donpivo/uTracer/README.md

Project description: https://retronics.no/tag/utracer/
