donpivo/uTracer/Models/TubePlate_Frame.stl

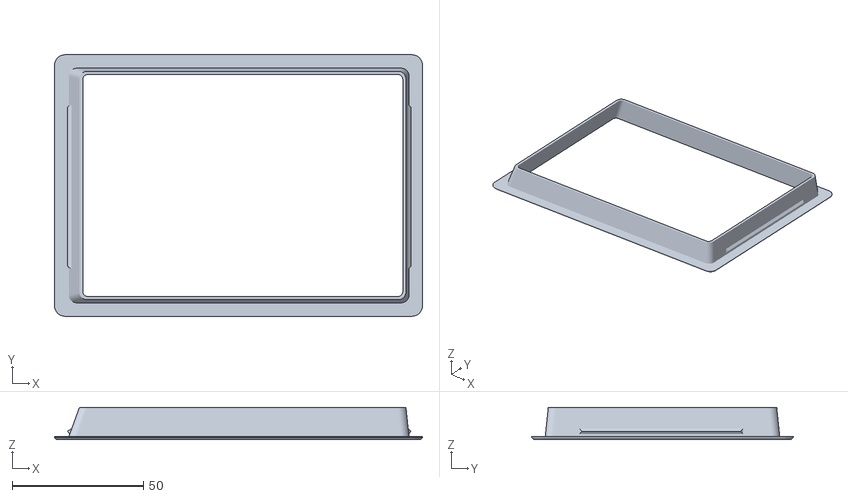
[picture p1: CAD file, 2023-02-20]
Models/TubePlate_Frame.stl
140.0 x 99.5 x 12.3
