donpivo/uTracer/Models/HeaterFrontPanel.3mf

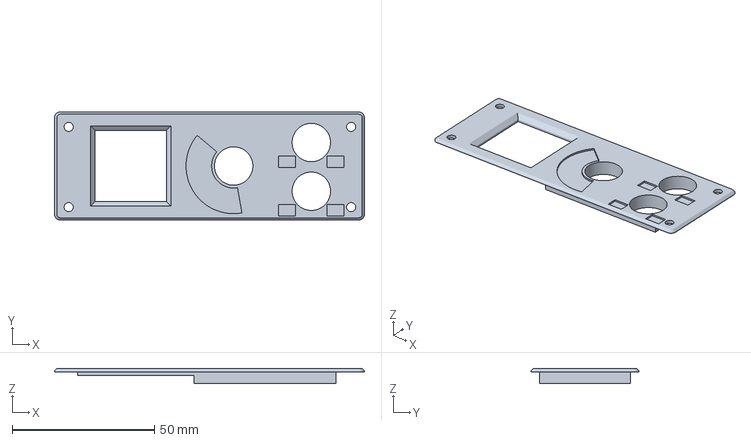
[picture p2: CAD file, 2023-02-17]
Models/HeaterFrontPanel.3mf
109.0 x 38.0 x 5.20 mm
