donpivo/uTracer/Models/ConnectorPlate.stl

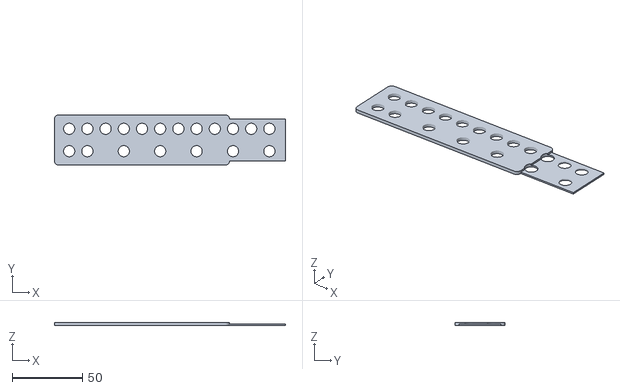
[picture p3: CAD file, 2023-02-17]
Models/ConnectorPlate.stl
165.0 x 36.0 x 2.10
