donpivo/uTracer/Models/HeaterFrontPanel_Insert.stl

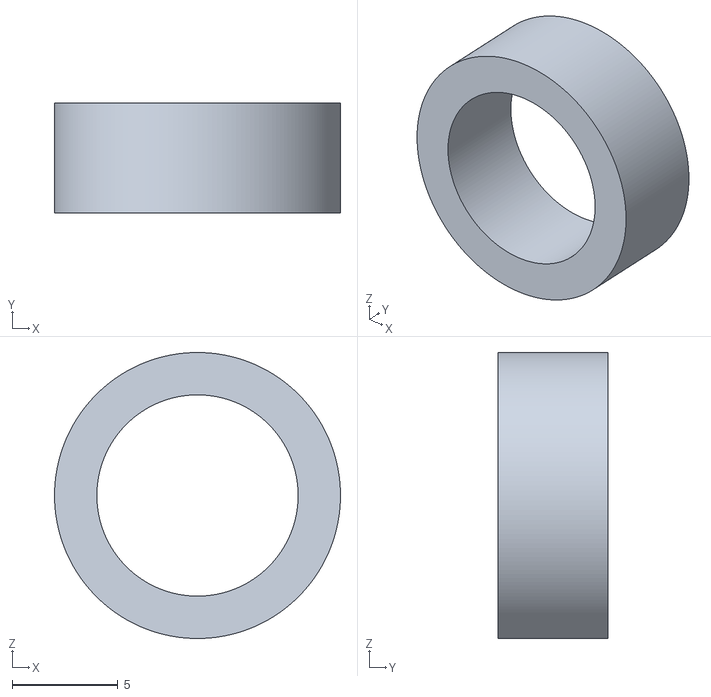
[picture p4: CAD file, 2023-02-16]
Models/HeaterFrontPanel_Insert.stl
13.5 x 5.20 x 13.5
