donpivo/uTracer/Models/CableProtection_2A.stl

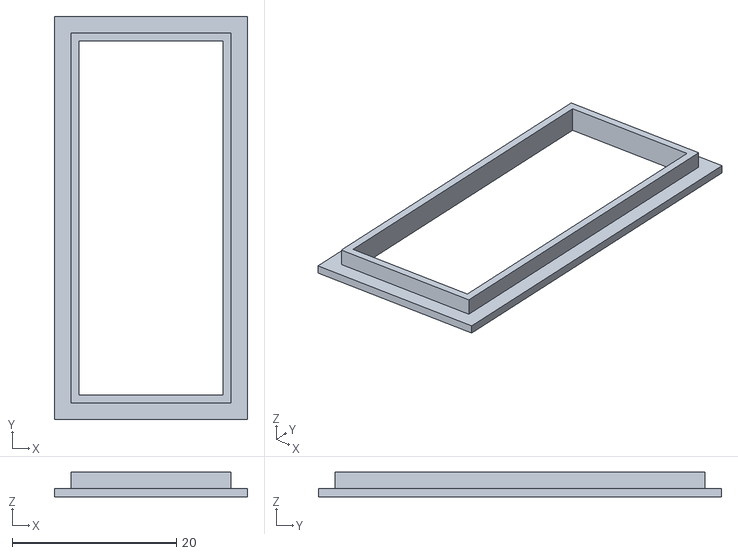
[picture p5: CAD file, 2023-01-22]
Models/CableProtection_2A.stl
23.5 x 49.0 x 3.00
