donpivo/uTracer/Models/CableProtection_1A.stl

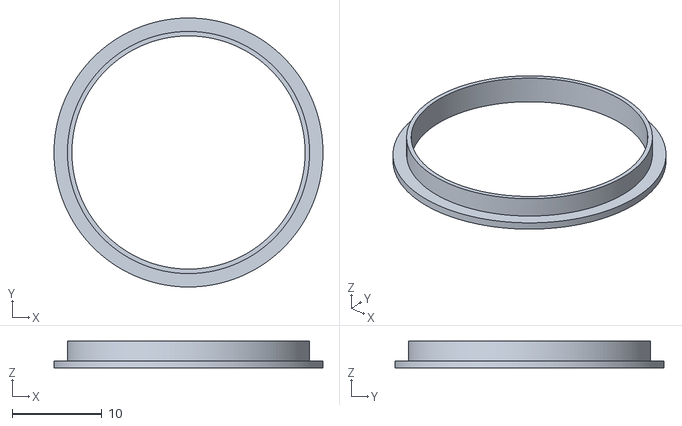
[picture p6: CAD file, 2023-01-22]
Models/CableProtection_1A.stl
30.0 x 30.0 x 3.00
