donpivo/uTracer/Models/CableProtection_1B.stl

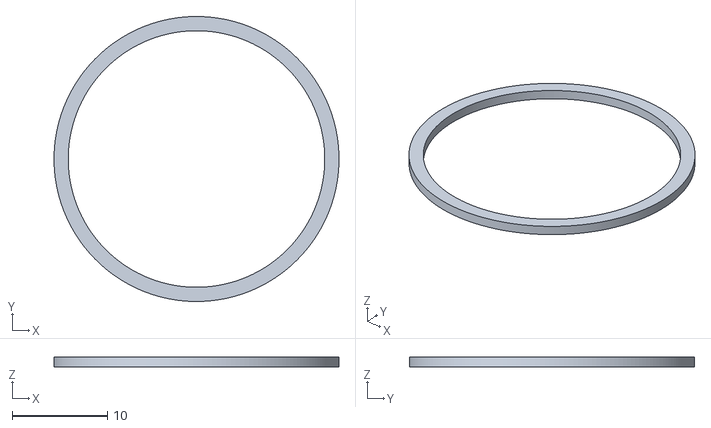
[picture p7: CAD file, 2023-01-22]
Models/CableProtection_1B.stl
30.0 x 30.0 x 1.00
