donpivo/uTracer/Models/CableProtection_2B.stl

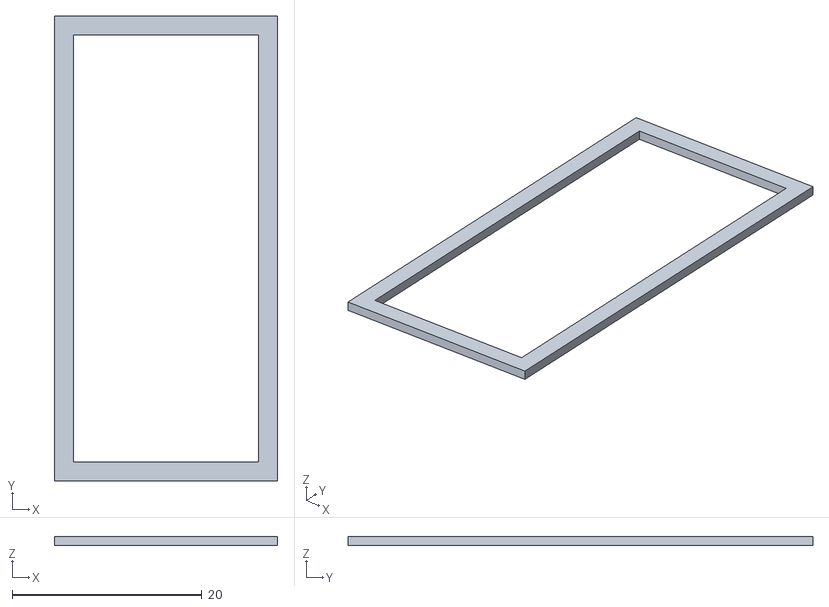
[picture p8: CAD file, 2023-01-22]
Models/CableProtection_2B.stl
23.5 x 49.0 x 1.00
