donpivo/uTracer/Models/HeaterHolder.stl

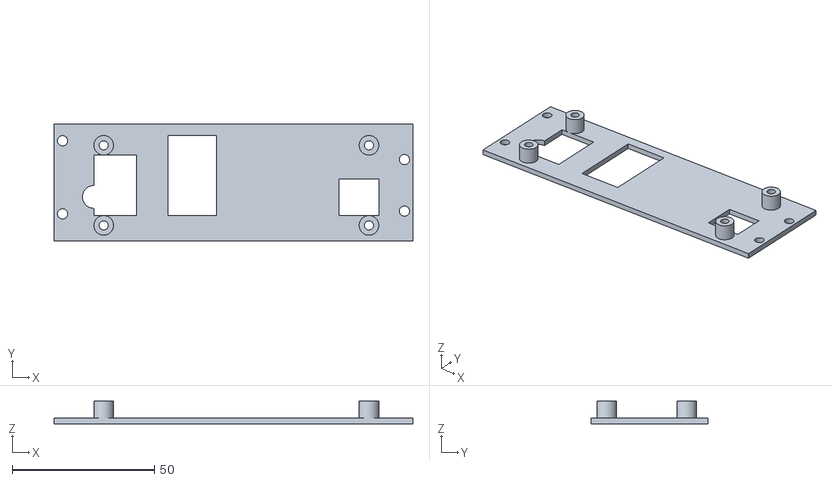
[picture p9: CAD file, 2023-01-22]
Models/HeaterHolder.stl
126.0 x 41.0 x 8.00
