donpivo/uTracer/Models/USBCover.stl

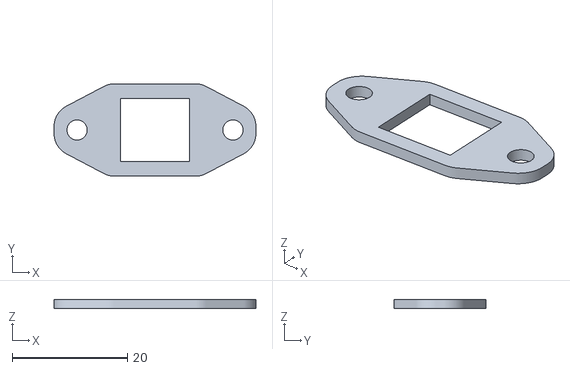
[picture p10: CAD file, 2023-01-12]
Models/USBCover.stl
35.0 x 16.0 x 1.60
