donpivo/uTracer/Models/ShieldHolder.stl

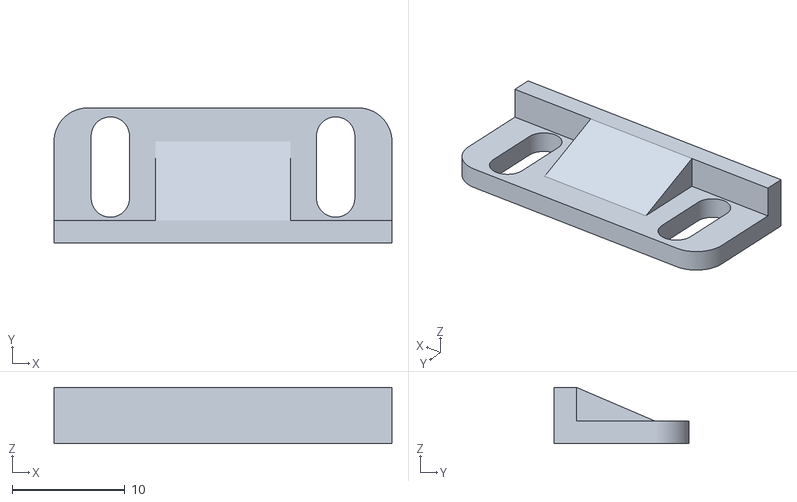
[picture p11: CAD file, 2022-11-03]
Models/ShieldHolder.stl
30.0 x 12.0 x 5.00
