donpivo/uTracer/(list of files, cad)

Other CAD files:
Models/TubePlate_Frame2.stl
Models/HeaterFrontPanel.stl
