donpivo/uTracer/Schematic/HeaterMCU/HeaterMCU.kicad_pcb

## KiCad design Schematic/HeaterMCU/HeaterMCU.kicad_pcb (2023-05-12)

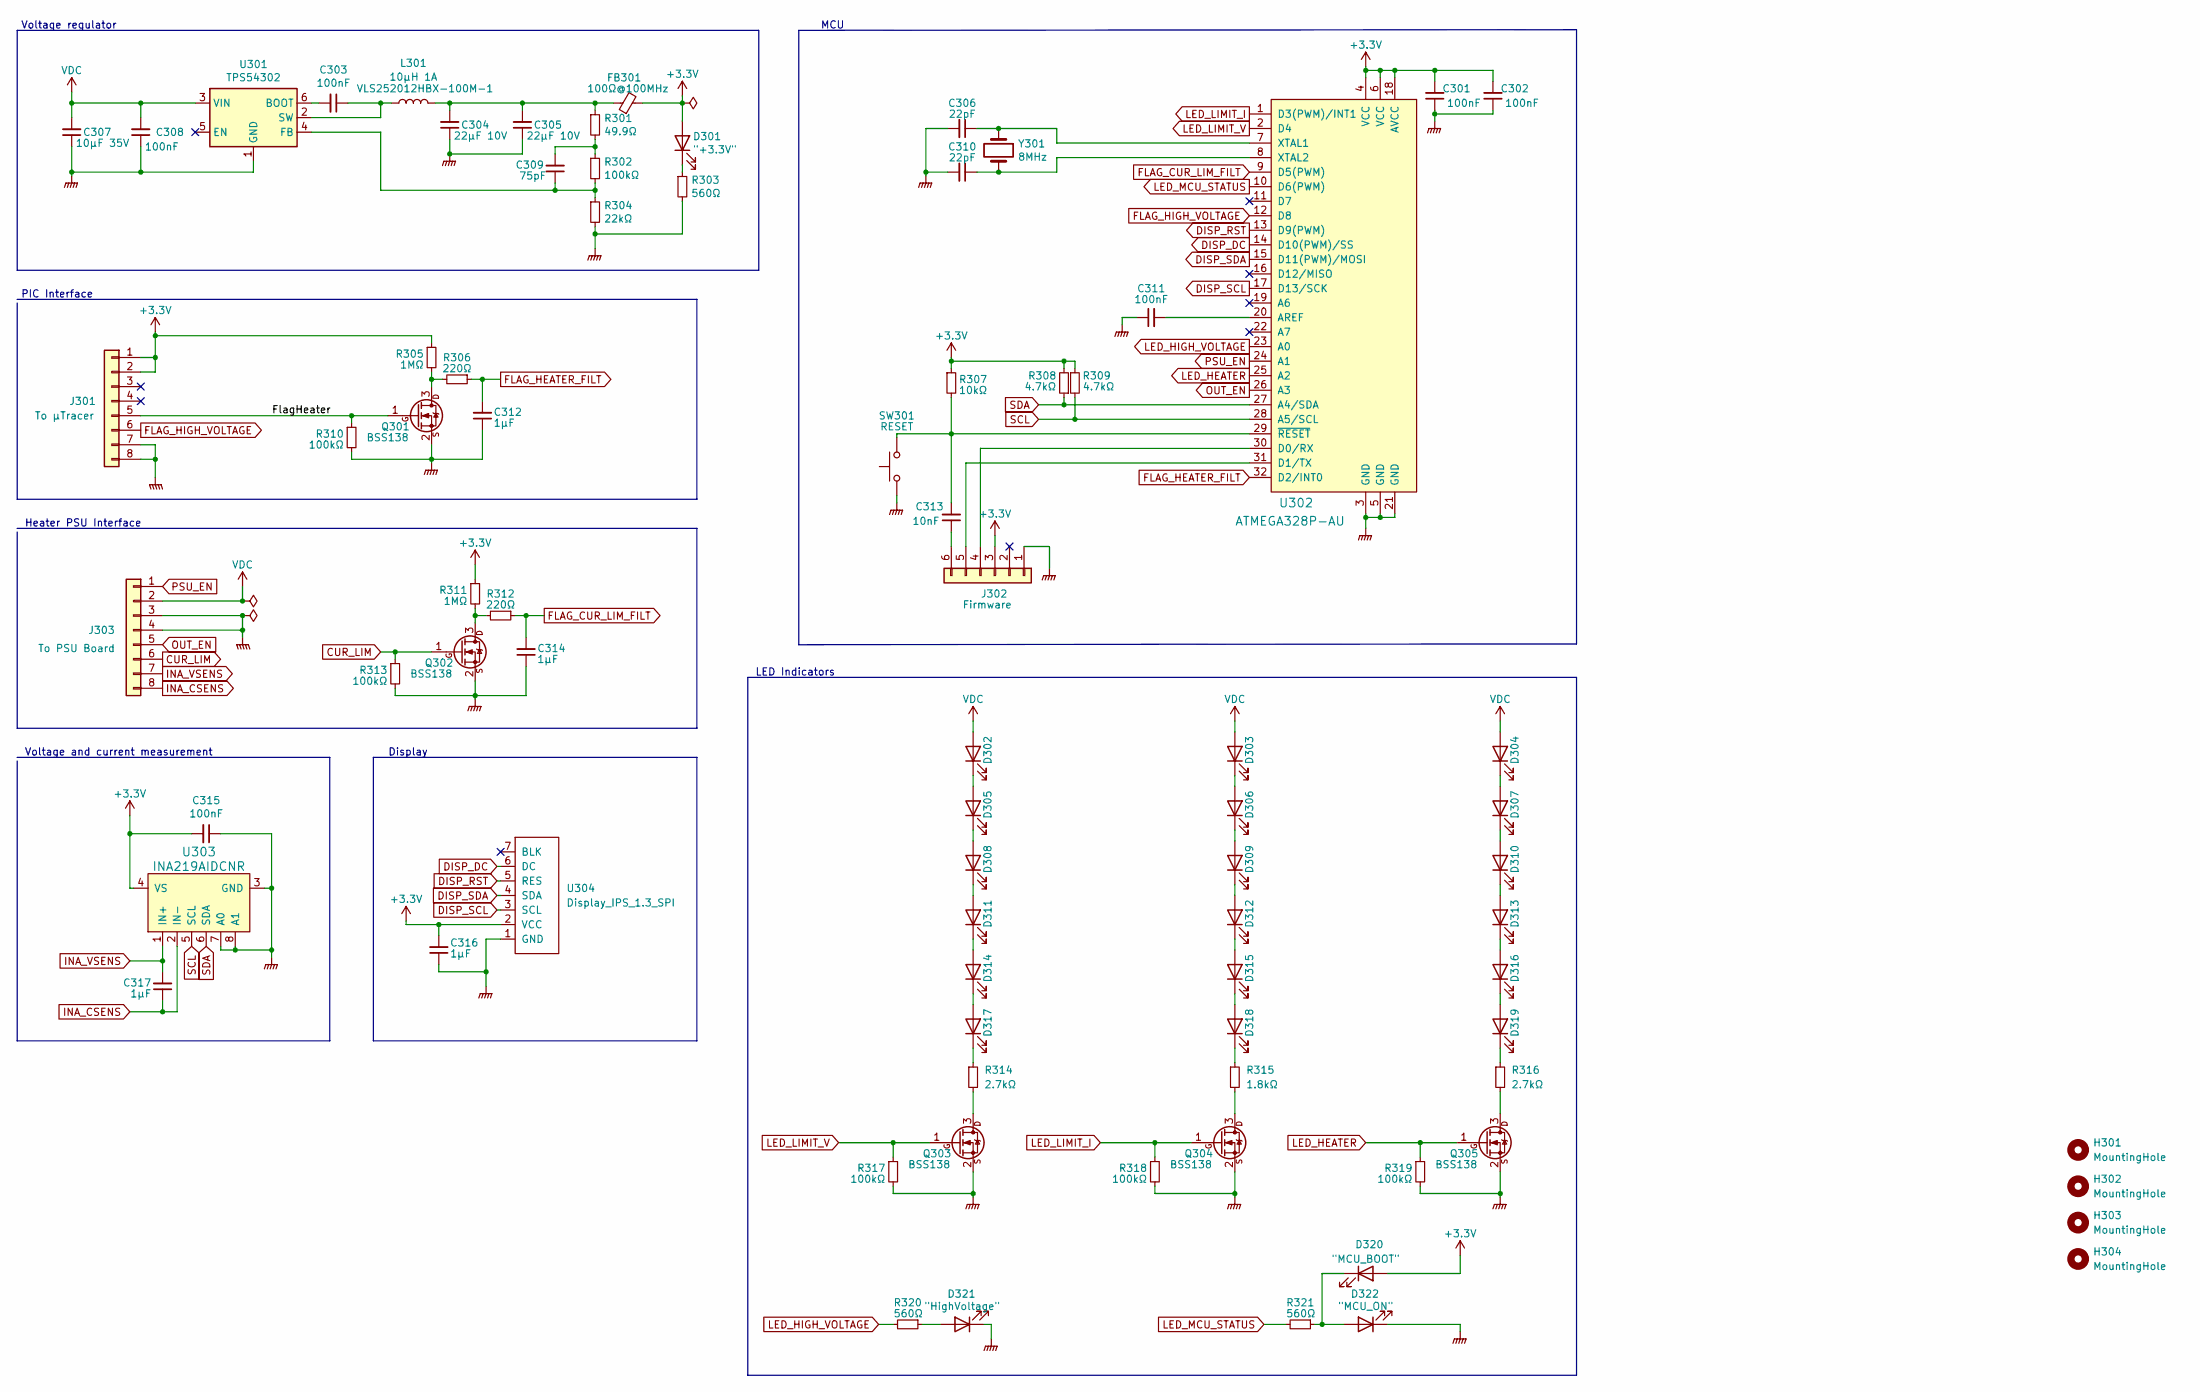
[picture p12: schematic HeaterMCU.kicad_sch, uTracer Heater - MCU Board]

Parts:
C301, C302, C303, C308, C311, C315: 100nF; C_0603_1608Metric_Pad1.08x0.95mm_HandSolder
C304, C305: 22µF 10V; C_0603_1608Metric_Pad1.08x0.95mm_HandSolder
C306, C310: 22pF; C_0603_1608Metric_Pad1.08x0.95mm_HandSolder
C307: 10µF 35V; C_0603_1608Metric_Pad1.08x0.95mm_HandSolder
C309: 75pF; C_0603_1608Metric_Pad1.08x0.95mm_HandSolder
C312, C314, C316, C317: 1µF; C_0603_1608Metric_Pad1.08x0.95mm_HandSolder
C313: 10nF; C_0603_1608Metric_Pad1.08x0.95mm_HandSolder
D301: "+3.3V"; LED_0603_1608Metric_Pad1.05x0.95mm_HandSolder
D302, D305, D308, D311, D314, D317: "Voltage limit"; LED_0603_1608Metric_Pad1.05x0.95mm_HandSolder
D303, D306, D309, D312, D315, D318: "Current limit"; LED_0603_1608Metric_Pad1.05x0.95mm_HandSolder
D304, D307, D310, D313, D316, D319: "Heater"; LED_0603_1608Metric_Pad1.05x0.95mm_HandSolder
D320: "MCU_BOOT"; LED_0603_1608Metric_Pad1.05x0.95mm_HandSolder
D321: "HighVoltage"; LED_0603_1608Metric_Pad1.05x0.95mm_HandSolder
D322: "MCU_ON"; LED_0603_1608Metric_Pad1.05x0.95mm_HandSolder
FB301: 100Ω@100MHz; L_0603_1608Metric_Pad1.05x0.95mm_HandSolder
H301, H302, H303, H304: MountingHole; MountingHole_3.2mm_M3
J301: To µTracer; 0527450897
J302: Firmware; PinHeader_1x06_P2.54mm_Vertical
J303: To PSU Board; PinHeader_1x08_P2.54mm_Vertical
L301: 10µH 1A; L_Taiyo-Yuden_NR-20xx_HandSoldering
Q301, Q302, Q303, Q304, Q305: BSS138; SOT-23
R301: 49.9Ω; R_0603_1608Metric_Pad0.98x0.95mm_HandSolder
R302, R310, R313, R317, R318, R319: 100kΩ; R_0603_1608Metric_Pad0.98x0.95mm_HandSolder
R303, R320, R321: 560Ω; R_0603_1608Metric_Pad0.98x0.95mm_HandSolder
R304: 22kΩ; R_0603_1608Metric_Pad0.98x0.95mm_HandSolder
R305, R311: 1MΩ; R_0603_1608Metric_Pad0.98x0.95mm_HandSolder
R306, R312: 220Ω; R_0603_1608Metric_Pad0.98x0.95mm_HandSolder
R307: 10kΩ; R_0603_1608Metric_Pad0.98x0.95mm_HandSolder
R308, R309: 4.7kΩ; R_0603_1608Metric_Pad0.98x0.95mm_HandSolder
R314, R316: 2.7kΩ; R_0603_1608Metric_Pad0.98x0.95mm_HandSolder
R315: 1.8kΩ; R_0603_1608Metric_Pad0.98x0.95mm_HandSolder
SW301: RESET; Tactile_sw_SMD_side_01
U301: TPS54302; SOT-23-6_Handsoldering
U302: ATMEGA328P-AU; TQFP-32_7x7mm
U303: INA219AIDCNR; SOT-23-8_Handsoldering; MPN INA219AIDCNR; Digi-Key_PN 296-23770-1-ND
U304: Display_IPS_1.3_SPI
Y301: 8MHz; Crystal_SMD_HC49-SD

Connections:
+3V3: C301.2, C302.2, C315.2, C316.2, D301.2 (A), D320.2 (A), FB301.2, J301.1, J301.2, J302.3, R305.1, R307.1, R308.2, R309.1, R311.1, U302.4 (VCC), U302.6 (VCC), U302.18 (AVCC), U303.4 (VS), U304.2 (VCC)
/FlagHeater: J301.5, Q301.1 (G), R310.1
CUR_LIM: J303.6, Q302.1 (G), R313.1
DISP_DC: U302.14 (D10(PWM)/SS), U304.6 (DC)
DISP_RST: U302.13 (D9(PWM)), U304.5 (RES)
DISP_SCL: U302.17 (D13/SCK), U304.3 (SCL)
DISP_SDA: U302.15 (D11(PWM)/MOSI), U304.4 (SDA)
FLAG_CUR_LIM_FILT: C314.2, R312.1, U302.9 (D5(PWM))
FLAG_HEATER_FILT: C312.2, R306.1, U302.32 (D2/INT0)
FLAG_HIGH_VOLTAGE: J301.6, U302.12 (D8)
GNDPWR: C301.1, C302.1, C304.1, C305.1, C306.2, C307.1, C308.1, C310.2, C311.1, C312.1, C314.1, C315.1, C316.1, D321.1 (K), D322.1 (K), J301.7, J301.8, J302.1, J303.3, J303.4, Q301.2 (S), Q302.2 (S), Q303.2 (S), Q304.2 (S), Q305.2 (S), R303.2, R304.2, R310.2, R313.2, R317.2, R318.2, R319.2, SW301.1, U301.1 (GND), U302.3 (GND), U302.5 (GND), U302.21 (GND), U303.3 (GND), U303.7 (A0), U303.8 (A1), U304.1 (GND)
INA_CSENS: C317.1, J303.8, U303.2 (IN-)
INA_VSENS: C317.2, J303.7, U303.1 (IN+)
LED_HEATER: Q305.1 (G), R319.1, U302.25 (A2)
LED_HIGH_VOLTAGE: R320.2, U302.23 (A0)
LED_LIMIT_I: Q304.1 (G), R318.1, U302.1 (D3(PWM)/INT1)
LED_LIMIT_V: Q303.1 (G), R317.1, U302.2 (D4)
LED_MCU_STATUS: R321.2, U302.10 (D6(PWM))
unnamed: C303.1, L301.1, U301.2 (SW)
unnamed: C303.2, U301.6 (BOOT)
unnamed: C304.2, C305.2, FB301.1, L301.2, R301.1
unnamed: C306.1, U302.7 (XTAL1), Y301.1
unnamed: C309.1, R302.2, R304.1, U301.4 (FB)
unnamed: C309.2, R301.2, R302.1
unnamed: C310.1, U302.8 (XTAL2), Y301.2
unnamed: C311.2, U302.20 (AREF)
unnamed: C313.1, J302.6
unnamed: C313.2, R307.2, SW301.2, U302.29 (~RESET)
unnamed: D301.1 (K), R303.1
unnamed: D302.1 (K), D305.2 (A)
unnamed: D303.1 (K), D306.2 (A)
unnamed: D304.1 (K), D307.2 (A)
unnamed: D305.1 (K), D308.2 (A)
unnamed: D306.1 (K), D309.2 (A)
unnamed: D307.1 (K), D310.2 (A)
unnamed: D308.1 (K), D311.2 (A)
unnamed: D309.1 (K), D312.2 (A)
unnamed: D310.1 (K), D313.2 (A)
unnamed: D311.1 (K), D314.2 (A)
unnamed: D312.1 (K), D315.2 (A)
unnamed: D313.1 (K), D316.2 (A)
unnamed: D314.1 (K), D317.2 (A)
unnamed: D315.1 (K), D318.2 (A)
unnamed: D316.1 (K), D319.2 (A)
unnamed: D317.1 (K), R314.1
unnamed: D318.1 (K), R315.1
unnamed: D319.1 (K), R316.1
unnamed: D320.1 (K), D322.2 (A), R321.1
unnamed: D321.2 (A), R320.1
unnamed: J302.4, U302.30 (D0/RX)
unnamed: J302.5, U302.31 (D1/TX)
unnamed: Q301.3 (D), R305.2, R306.2
unnamed: Q302.3 (D), R311.2, R312.2
unnamed: Q303.3 (D), R314.2
unnamed: Q304.3 (D), R315.2
unnamed: Q305.3 (D), R316.2
OUT_EN: J303.5, U302.26 (A3)
PSU_EN: J303.1, U302.24 (A1)
SCL: R309.2, U302.28 (A5/SCL), U303.5 (SCL)
SDA: R308.1, U302.27 (A4/SDA), U303.6 (SDA)
VDC: C307.2, C308.2, D302.2 (A), D303.2 (A), D304.2 (A), J303.2, U301.3 (VIN)

Notes on the sheet:
Voltage regulator
Heater PSU Interface
Display
PIC Interface
LED Indicators
MCU
Voltage and current measurement

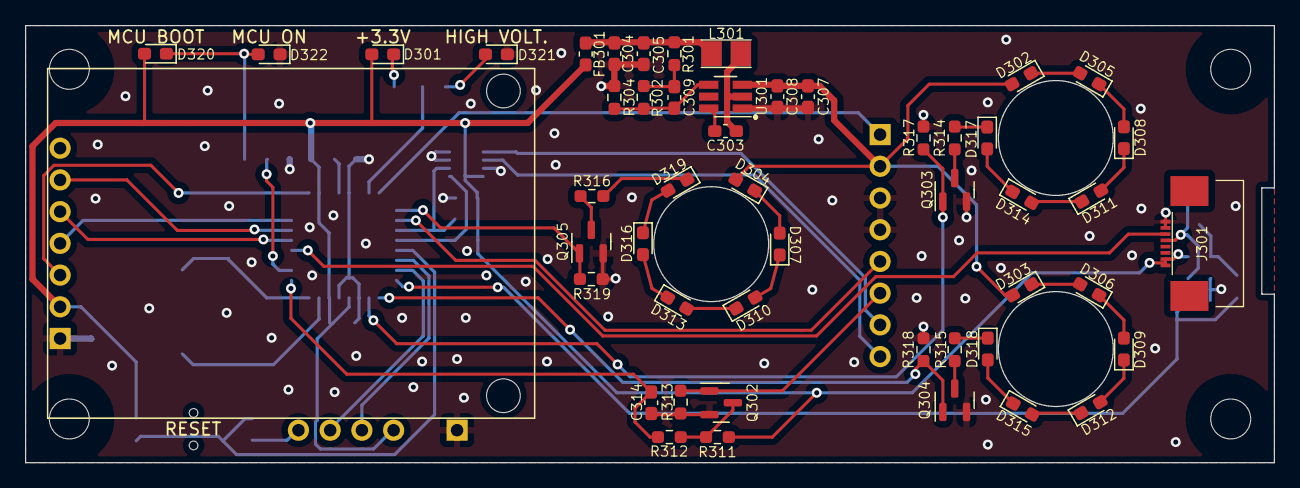
[picture p13: board HeaterMCU.kicad_pcb from above]

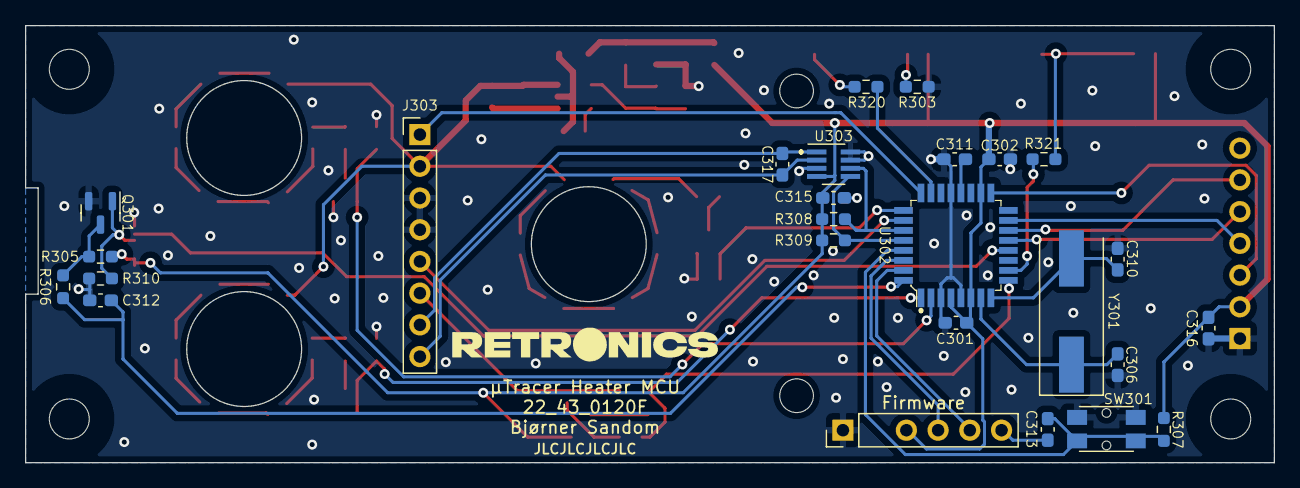
[picture p14: board HeaterMCU.kicad_pcb from below]

Board: 2 copper layers, 100.0 x 35.0 mm, 80 parts (26 on the bottom side), 61 nets.
