donpivo/uTracer/Schematic/HeaterPSU/HeaterPSU.kicad_pcb

## KiCad design Schematic/HeaterPSU/HeaterPSU.kicad_pcb (2023-01-23)

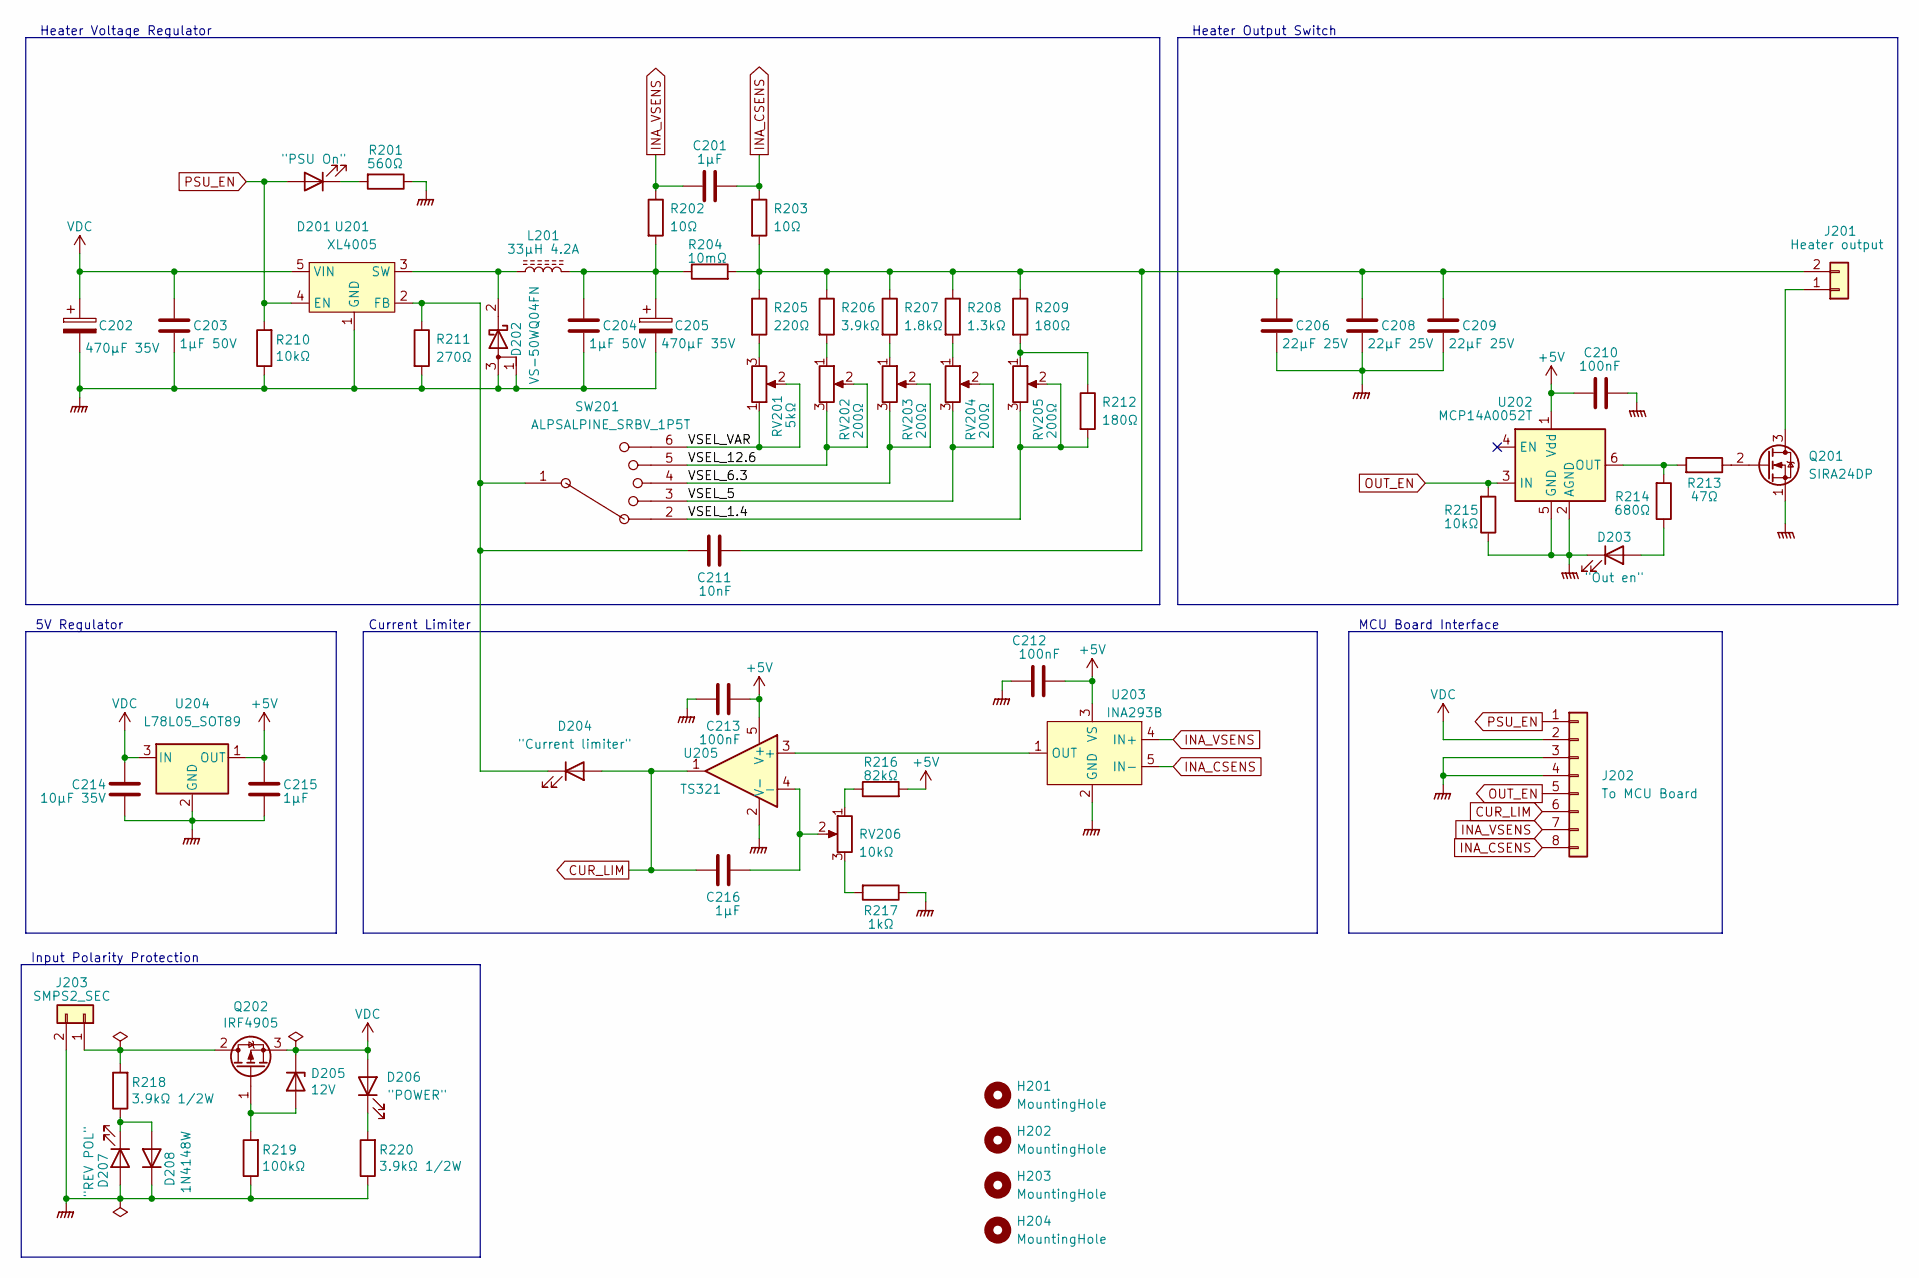
[picture p15: schematic HeaterPSU.kicad_sch, uTracer HeaterPSU]

Parts:
C201, C215, C216: 1µF; C_0603_1608Metric_Pad1.08x0.95mm_HandSolder
C202, C205: 470µF 35V; CP_Elec_8x10
C203, C204: 1µF 50V; C_0805_2012Metric_Pad1.18x1.45mm_HandSolder
C206, C208, C209: 22µF 25V; C_0805_2012Metric_Pad1.18x1.45mm_HandSolder
C210, C212, C213: 100nF; C_0603_1608Metric_Pad1.08x0.95mm_HandSolder
C211: 10nF; C_0805_2012Metric_Pad1.18x1.45mm_HandSolder
C214: 10µF 35V; C_0603_1608Metric_Pad1.08x0.95mm_HandSolder
D201: "PSU On"; LED_0603_1608Metric_Pad1.05x0.95mm_HandSolder
D202: VS-50WQ04FN; TO-252-2
D203: "Out en"; LED_0603_1608Metric_Pad1.05x0.95mm_HandSolder
D204: "Current limiter"; LED_0603_1608Metric_Pad1.05x0.95mm_HandSolder
D205: 12V; D_SOD-123
D206: "POWER"; LED_0603_1608Metric_Pad1.05x0.95mm_HandSolder
D207: "REV POL"; LED_0603_1608Metric_Pad1.05x0.95mm_HandSolder
D208: 1N4148W; D_SOD-123
H201, H202, H203, H204: MountingHole; MountingHole_3.2mm_M3
J201: Heater output; TerminalBlock_LCSC_P5.08mm
J202: To MCU Board; PinSocket_1x08_P2.54mm_Vertical
J203: SMPS2_SEC; TerminalBlock_LCSC_P5.08mm
L201: 33µH 4.2A; L_12x12mm_H8mm
Q201: SIRA24DP; SIRA24DP-T1-GE3
Q202: IRF4905; TO-263-2
R201: 560Ω; R_0603_1608Metric_Pad0.98x0.95mm_HandSolder
R202, R203: 10Ω; R_0805_2012Metric_Pad1.20x1.40mm_HandSolder
R204: 10mΩ; R_2512_6332Metric_Pad1.40x3.35mm_HandSolder
R205: 220Ω; R_0805_2012Metric_Pad1.20x1.40mm_HandSolder
R206: 3.9kΩ; R_0805_2012Metric_Pad1.20x1.40mm_HandSolder
R207: 1.8kΩ; R_0805_2012Metric_Pad1.20x1.40mm_HandSolder
R208: 1.3kΩ; R_0805_2012Metric_Pad1.20x1.40mm_HandSolder
R209, R212: 180Ω; R_0805_2012Metric_Pad1.20x1.40mm_HandSolder
R210: 10kΩ; R_0805_2012Metric_Pad1.20x1.40mm_HandSolder
R211: 270Ω; R_0805_2012Metric_Pad1.20x1.40mm_HandSolder
R213: 47Ω; R_0603_1608Metric_Pad0.98x0.95mm_HandSolder
R214: 680Ω; R_0603_1608Metric_Pad0.98x0.95mm_HandSolder
R215: 10kΩ; R_0603_1608Metric_Pad0.98x0.95mm_HandSolder
R216: 82kΩ; R_0603_1608Metric_Pad0.98x0.95mm_HandSolder
R217: 1kΩ; R_0603_1608Metric_Pad0.98x0.95mm_HandSolder
R218, R220: 3.9kΩ 1/2W; R_1210_3225Metric_Pad1.30x2.65mm_HandSolder
R219: 100kΩ; R_0805_2012Metric_Pad1.20x1.40mm_HandSolder
RV201: 5kΩ; Potentiometer_Bourns_PTV09A-1_Single_Vertical
RV202, RV203, RV204, RV205: 200Ω; Potentiometer_TT_35W
RV206: 10kΩ; Potentiometer_Bourns_PTV09A-1_Single_Vertical
SW201: ALPSALPINE_SRBV_1P5T; SRBV141404
U201: XL4005; TO-263-5_TabPin3
U202: MCP14A0052T; SOT-23-6_Handsoldering
U203: INA293B; SOT-23-5_HandSoldering
U204: L78L05_SOT89; SOT-89-3
U205: TS321; SOT-23-5_HandSoldering

Connections:
+5V: C210.2, C212.2, C213.2, C215.2, R216.2, U202.1 (Vdd), U203.3 (VS), U204.1 (OUT), U205.5 (V+)
/VSEL_1.4: R212.2, RV205.2, RV205.3, SW201.2
/VSEL_5: RV204.2, RV204.3, SW201.3
/VSEL_6.3: RV203.2, RV203.3, SW201.4
/VSEL_12.6: RV202.2, RV202.3, SW201.5
/VSEL_VAR: RV201.1, RV201.2, SW201.6
CUR_LIM: C216.1, D204.2 (A), J202.6, U205.1
GNDPWR: C202.2, C203.2, C204.2, C205.2, C206.2, C208.2, C209.2, C210.1, C212.1, C213.1, C214.1, C215.1, D202.1 (A), D202.3 (A), D203.1 (K), D207.2 (A), D208.1 (K), J202.3, J202.4, J203.2, Q201.1 (S), R201.1, R210.1, R211.2, R215.1, R217.1, R219.1, R220.1, U201.1 (GND), U202.2 (AGND), U202.5 (GND), U203.2 (GND), U204.2 (GND), U205.2 (V-)
INA_CSENS: C201.1, J202.8, R203.1, U203.5 (IN-)
INA_VSENS: C201.2, J202.7, R202.1, U203.4 (IN+)
unnamed: C204.1, C205.1, L201.2, R202.2, R204.1
unnamed: C211.1, D204.1 (K), R211.1, SW201.1, U201.2 (FB)
unnamed: C206.1, C208.1, C209.1, C211.2, J201.2, R203.2, R204.2, R205.1, R206.1, R207.1, R208.1, R209.1
unnamed: C216.2, RV206.2, U205.4 (-)
unnamed: D201.1 (K), R201.2
unnamed: D202.2 (K), L201.1, U201.3 (SW)
unnamed: D203.2 (A), R214.1
unnamed: D205.2 (A), Q202.1 (G), R219.2
unnamed: D206.1 (K), R220.2
unnamed: D207.1 (K), D208.2 (A), R218.1
unnamed: J201.1, Q201.3 (D)
unnamed: J203.1, Q202.2 (D), R218.2
unnamed: Q201.2 (G), R213.1
unnamed: R205.2, RV201.3
unnamed: R206.2, RV202.1
unnamed: R207.2, RV203.1
unnamed: R208.2, RV204.1
unnamed: R209.2, R212.1, RV205.1
unnamed: R213.2, R214.2, U202.6 (OUT)
unnamed: R216.1, RV206.1
unnamed: R217.2, RV206.3
unnamed: U203.1 (OUT), U205.3 (+)
OUT_EN: J202.5, R215.2, U202.3 (IN)
PSU_EN: D201.2 (A), J202.1, R210.2, U201.4 (EN)
VDC: C202.1, C203.1, C214.2, D205.1 (K), D206.2 (A), J202.2, Q202.3 (S), U201.5 (VIN), U204.3 (IN)

Notes on the sheet:
MCU Board Interface
5V Regulator
Heater Voltage Regulator
Input Polarity Protection
Current Limiter
Heater Output Switch

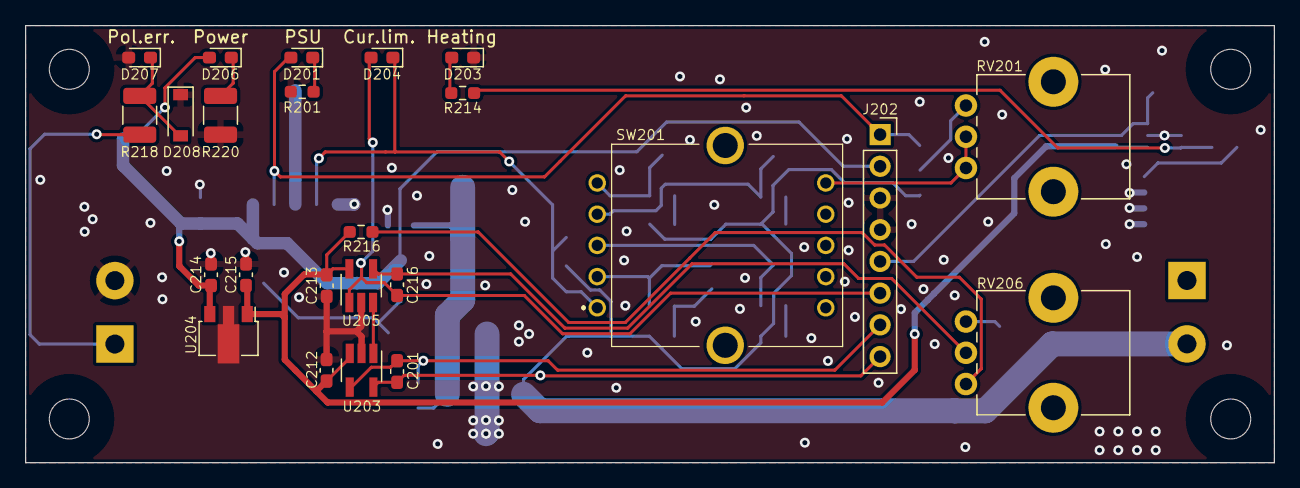
[picture p16: board HeaterPSU.kicad_pcb from above]

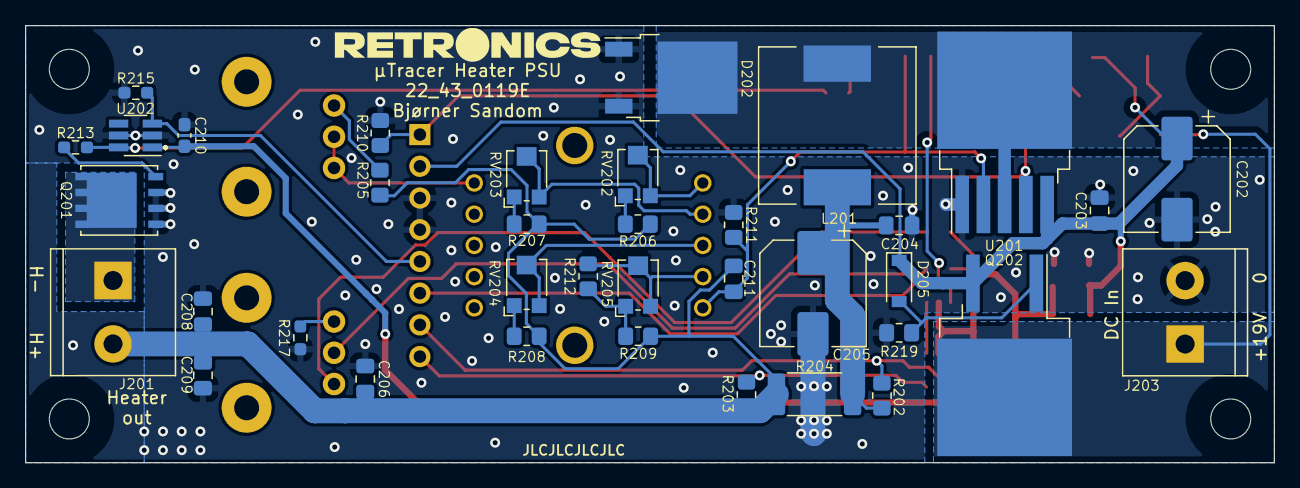
[picture p17: board HeaterPSU.kicad_pcb from below]

Board: 2 copper layers, 100.0 x 35.0 mm, 65 parts (37 on the bottom side), 35 nets.
