donpivo/uTracer/Schematic/PIC_Interface/PIC_Interface.kicad_pcb

## KiCad design Schematic/PIC_Interface/PIC_Interface.kicad_pcb (2023-01-05)

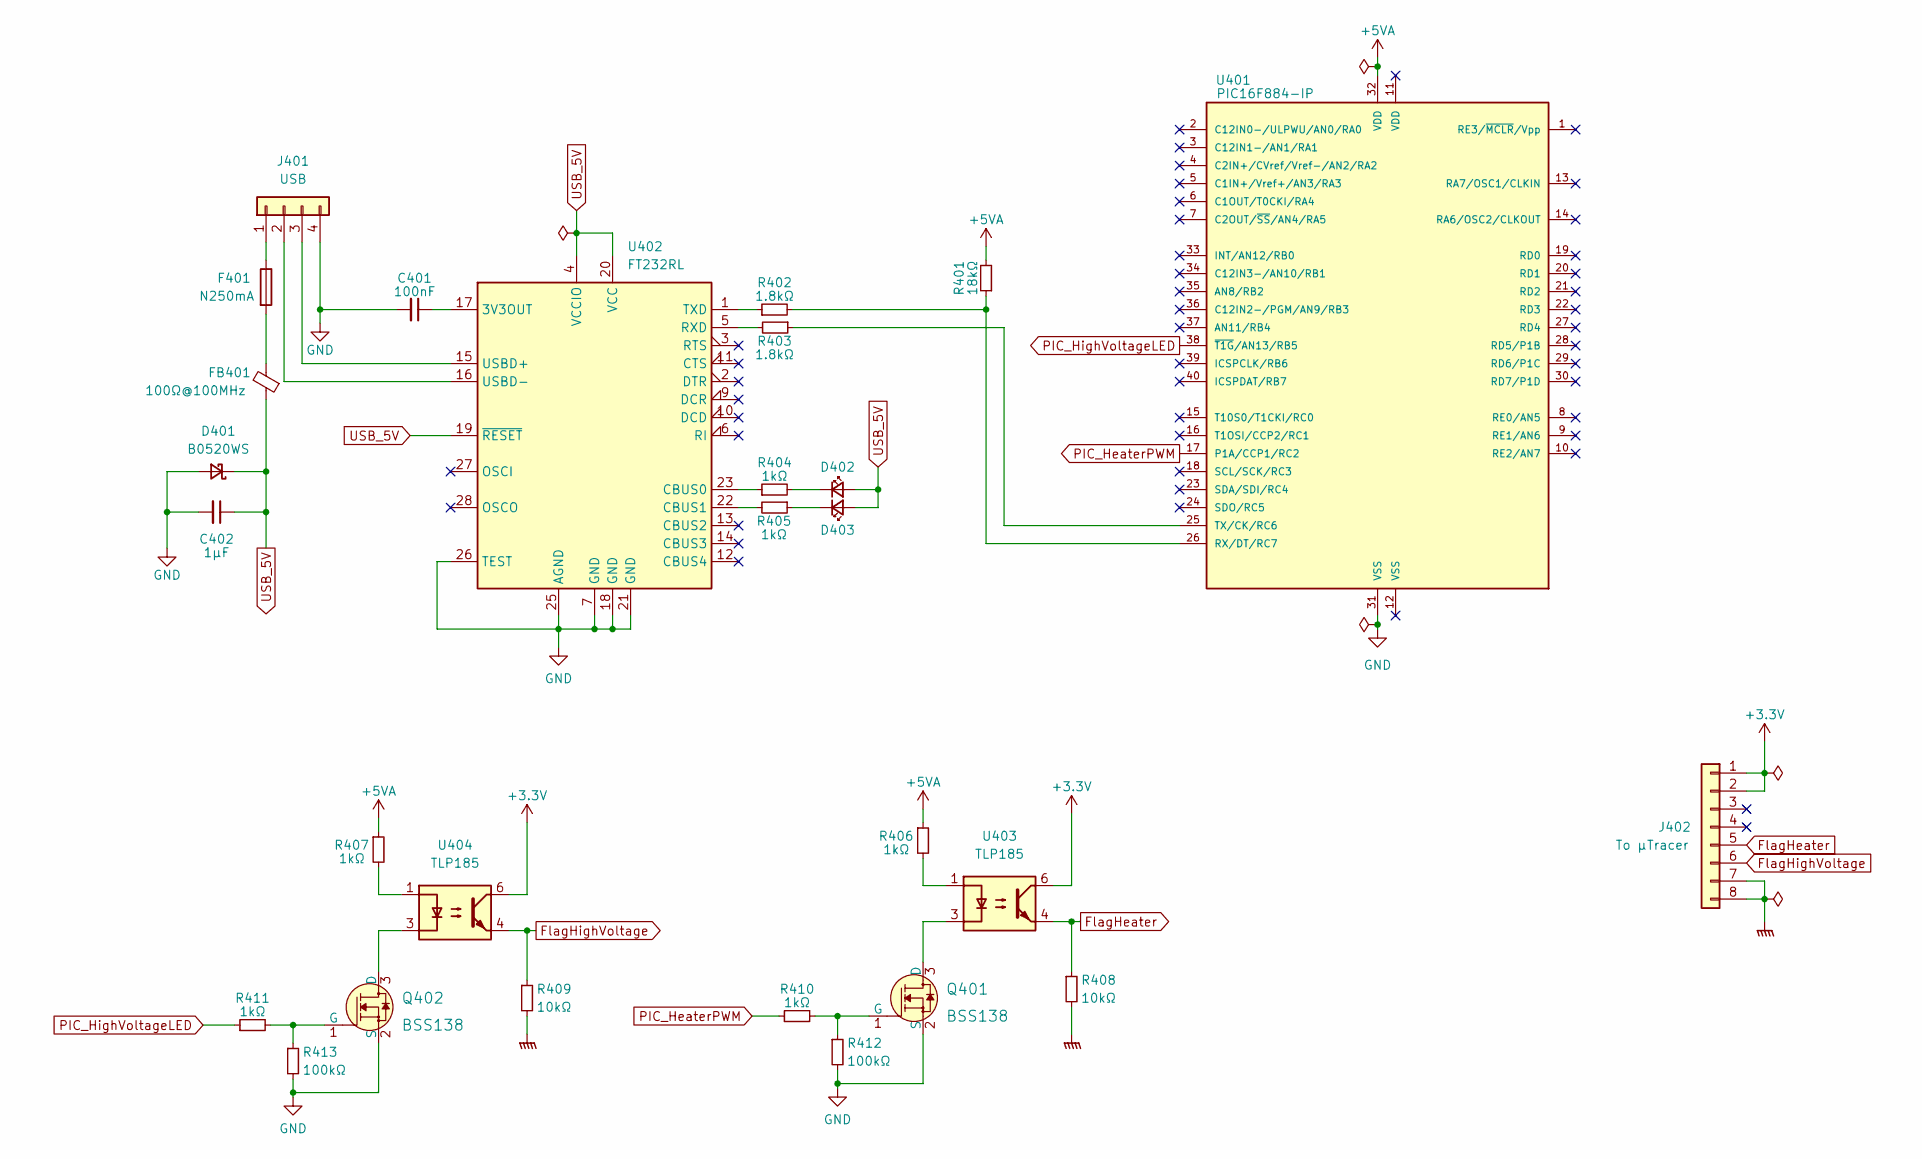
[picture p18: schematic PIC_Interface.kicad_sch, µTracer PIC Interface]

Parts:
C401: 100nF; C_0603_1608Metric_Pad1.08x0.95mm_HandSolder
C402: 1µF; C_0603_1608Metric_Pad1.08x0.95mm_HandSolder
D401: B0520WS; D_SOD-323_HandSoldering
D402, D403: LED_Small; LED_0603_1608Metric_Pad1.05x0.95mm_HandSolder
F401: N250mA; Fuse_1206_3216Metric_Pad1.42x1.75mm_HandSolder
FB401: 100Ω@100MHz; L_0603_1608Metric_Pad1.05x0.95mm_HandSolder
J401: USB; KF2510-4P
J402: To µTracer; 0527450897
Q401, Q402: BSS138; SOT-23-3; MPN BSS138; Digi-Key_PN BSS138CT-ND
R401: 18kΩ; R_0603_1608Metric_Pad0.98x0.95mm_HandSolder
R402, R403: 1.8kΩ; R_0603_1608Metric_Pad0.98x0.95mm_HandSolder
R404, R405, R406, R407, R410, R411: 1kΩ; R_0603_1608Metric_Pad0.98x0.95mm_HandSolder
R408, R409: 10kΩ; R_0603_1608Metric_Pad0.98x0.95mm_HandSolder
R412, R413: 100kΩ; R_0603_1608Metric_Pad0.98x0.95mm_HandSolder
U401: PIC16F884-IP; DIP-40_W15.24mm_Socket_ThroughPCB
U402: FT232RL; SSOP-28_5.3x10.2mm_P0.65mm
U403, U404: TLP185; SOIC-4_4.55x3.7mm_P2.54mm

Connections:
+3V3: J402.1, J402.2, U403.6, U404.6
+5VA: R401.2, R406.1, R407.1, U401.32 (VDD)
FlagHeater: J402.5, R408.1, U403.4
FlagHighVoltage: J402.6, R409.1, U404.4
GND: C401.2, C402.2, D401.2 (A), J401.4, Q401.2 (S), Q402.2 (S), R412.2, R413.2, U401.31 (VSS), U402.7 (GND), U402.18 (GND), U402.21 (GND), U402.25 (AGND), U402.26 (TEST)
GNDPWR: J402.7, J402.8, R408.2, R409.2
unnamed: C401.1, U402.17 (3V3OUT)
unnamed: D402.1 (K), R404.2
unnamed 8: D403.1 (K), R405.1; also elsewhere on the board
unnamed: F401.1, J401.1
unnamed: F401.2, FB401.2
unnamed: J401.2, U402.16 (USBD-)
unnamed: J401.3, U402.15 (USBD+)
unnamed: Q401.1 (G), R410.2, R412.1
unnamed: Q401.3 (D), U403.3
unnamed: Q402.1 (G), R411.2, R413.1
unnamed: Q402.3 (D), U404.3
unnamed: R401.1, R402.2, U401.26 (RX/DT/RC7)
unnamed: R402.1, U402.1 (TXD)
unnamed: R403.1, U401.25 (TX/CK/RC6)
unnamed: R403.2, U402.5 (RXD)
unnamed: R404.1, U402.23 (CBUS0)
unnamed: R405.2, U402.22 (CBUS1)
unnamed: R406.2, U403.1
unnamed: R407.2, U404.1
PIC_HeaterPWM: R410.1, U401.17 (P1A/CCP1/RC2)
PIC_HighVoltageLED: R411.1, U401.38 (~T1G/AN13/RB5)
USB_5V: C402.1, D401.1 (K), D402.2 (A), D403.2 (A), FB401.1, U402.4 (VCCIO), U402.19 (~RESET), U402.20 (VCC); also elsewhere on the board

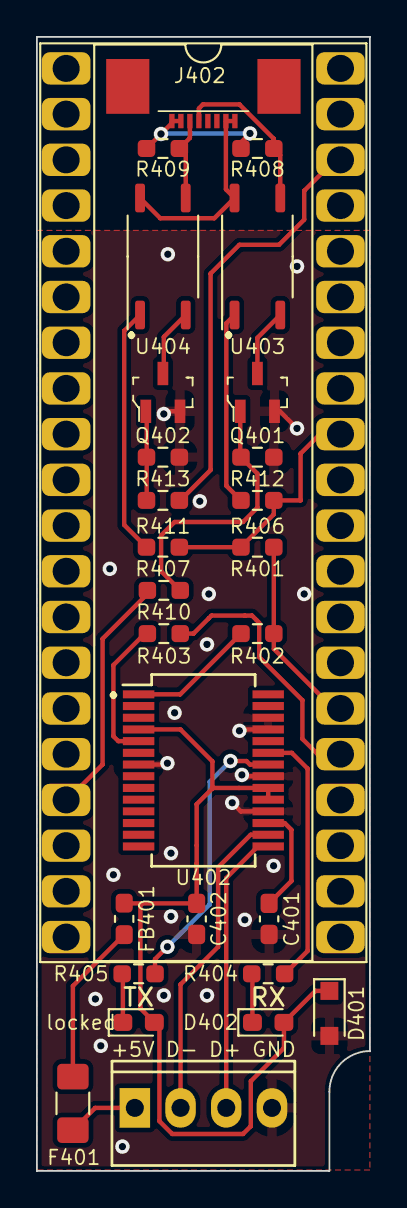
[picture p19: board PIC_Interface.kicad_pcb from above]

Board: 2 copper layers, 18.5 x 63.0 mm, 28 parts (0 on the bottom side), 28 nets.

Other parts of the board:
locked: LED_Small; LED_0603_1608Metric_Pad1.05x0.95mm_HandSolder

Their connections:
unnamed 8: locked.1 (K); also elsewhere on the board
USB_5V: locked.2 (A); also elsewhere on the board
