donpivo/uTracer/Schematic/PowerInput/PowerInput.kicad_pcb

## KiCad design Schematic/PowerInput/PowerInput.kicad_pcb (2022-10-31)

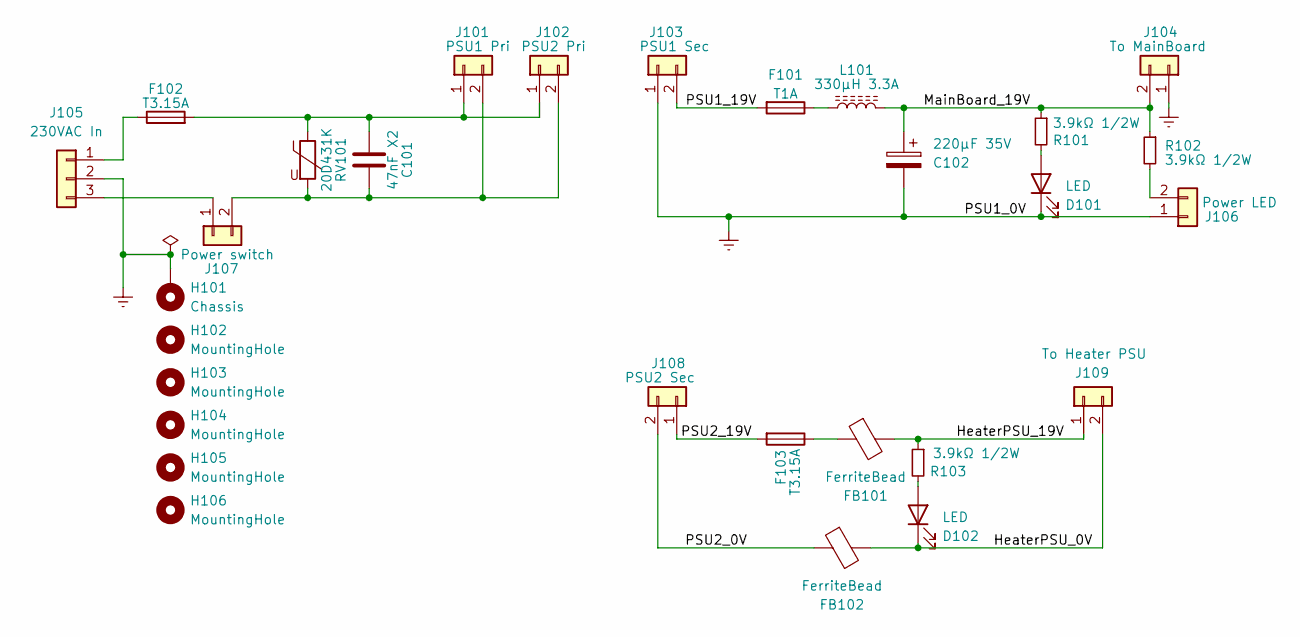
[picture p20: schematic PowerInput.kicad_sch]

Parts:
C101: 47nF X2; C_Rect_L13.0mm_W5.0mm_P10.00mm_FKS3_FKP3_MKS4
C102: 220µF 35V; CP_Radial_D10.0mm_P7.50mm
D101, D102: LED; LED_0805_2012Metric_Pad1.15x1.40mm_HandSolder
F101: T1A; Fuse_Littelfuse_372_D8.50mm
F102, F103: T3.15A; Fuse_Littelfuse_372_D8.50mm
FB101, FB102: FerriteBead; L_1812_4532Metric_Pad1.30x3.40mm_HandSolder
H101: Chassis; MountingHole_3.2mm_M3_Pad_Via
H102, H103, H104, H105, H106: MountingHole; MountingHole_3.2mm_M3
J101: PSU1 Pri; TerminalBlock_LCSC_P5.08mm
J102: PSU2 Pri; TerminalBlock_LCSC_P5.08mm
J103: PSU1 Sec; TerminalBlock_LCSC_P5.08mm
J104: To MainBoard; TerminalBlock_LCSC_P5.08mm
J105: 230VAC In; TerminalBlock_LCSC_P5.08mm_3
J106: Power LED; PinHeader_1x02_P2.54mm_Vertical
J107: Power switch; TerminalBlock_LCSC_P5.08mm
J108: PSU2 Sec; TerminalBlock_LCSC_P5.08mm
J109: To Heater PSU; TerminalBlock_LCSC_P5.08mm
L101: 330µH 3.3A; L_Radial_D24.4mm_P23.70mm_Murata_1400series
R101, R102, R103: 3.9kΩ 1/2W; R_1210_3225Metric_Pad1.30x2.65mm_HandSolder
RV101: 20D431K; RV_Disc_D21.5mm_W5.6mm_P10mm

Connections:
/HeaterPSU_0V: D102.1 (K), FB102.2, J109.2
/HeaterPSU_19V: FB101.2, J109.1, R103.1
/MainBoard_19V: C102.1, J104.2, L101.1, R101.1, R102.1
/PSU1_19V: F101.2, J103.2
/PSU2_0V: FB102.1, J108.2
/PSU2_19V: F103.2, J108.1
Earth: C102.2, D101.1 (K), H101.1, J103.1, J104.1, J105.2, J106.1
unnamed: C101.1, F102.2, J101.1, J102.1, RV101.1
unnamed: C101.2, J101.2, J102.2, J107.2, RV101.2
unnamed: D101.2 (A), R101.2
unnamed: D102.2 (A), R103.2
unnamed: F101.1, L101.2
unnamed: F102.1, J105.1
unnamed: F103.1, FB101.1
unnamed: J105.3, J107.1
unnamed: J106.2, R102.2

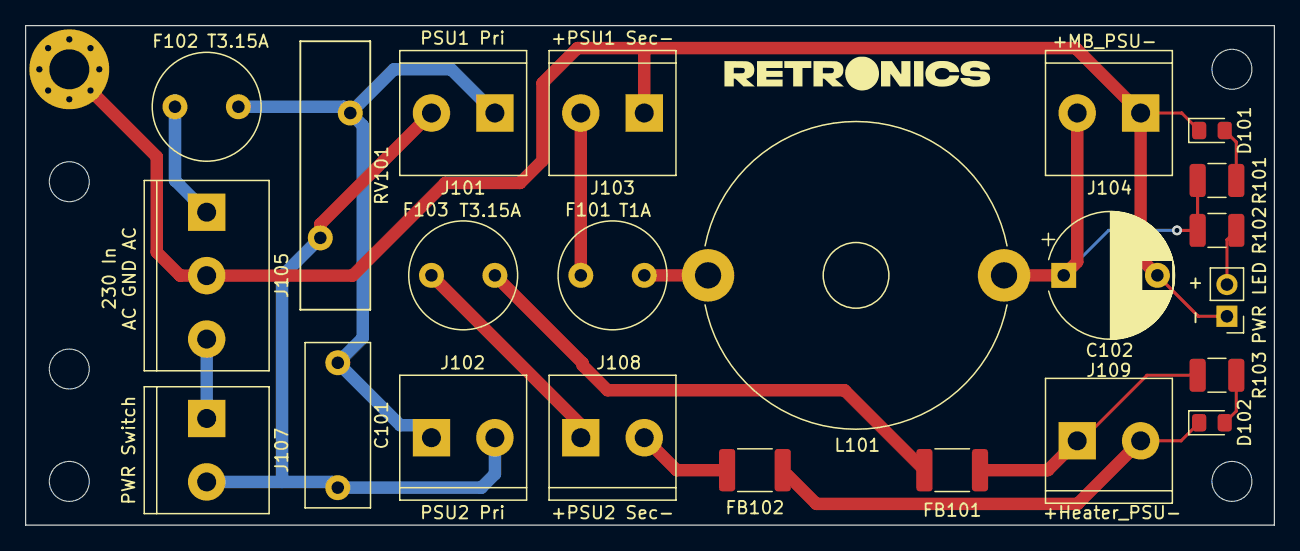
[picture p21: board PowerInput.kicad_pcb from above]

Board: 2 copper layers, 100.0 x 40.0 mm, 29 parts (0 on the bottom side), 16 nets.
