donpivo/uTracer/Code/Firmware/firmware/display.ino

void updateDisplayVoltage(float voltage)
{
  display.setTextSize(7);
  display.fillRect(0, 0, 180, 60, BLACK);
  display.setTextColor(WHITE);  
  display.setCursor(3, 3);
  String strVoltage=voltage<10?" "+String(voltage,1):String(voltage,1);
  display.print(strVoltage);
  display.setCursor(193, 3);
  display.setTextColor(GREY);
  display.print("V");
}

void updateDisplayCurrent(float current)
{
  display.setTextSize(7);
  display.fillRect(0, 63, 180, 60, BLACK);
  display.setTextColor(WHITE);
  display.setCursor(3, 63);
  String strCurrent=current<10?" "+String(current,1):String(current,1);
  display.print(strCurrent);
  display.setCursor(193, 63);
  display.setTextColor(GREY);
  display.print("A");
}

void updateDisplayStatus()
{
  display.setTextSize(3);
  if(heaterOn)
  {
    display.setTextColor(0xE880);
  }
  else
  {
    display.setTextColor(BLACK);
  }  
  display.setCursor(3, 150);
  display.print("Heating");

  if(currentLimited)
  {
    display.setTextColor(YELLOW);
  }
  else
  {
    display.setTextColor(BLACK);
  }  
  display.setCursor(3, 180);
  display.print("Current limit");
  
  if(highVoltage)
  {
    display.setTextColor(BLUE);
  }
  else
  {
    display.setTextColor(BLACK);
  }  
  display.setCursor(3, 210);
  display.print("High voltage");



  displayStatechange=false;
}
