donpivo/uTracer/(commit log)

2022-10-30 First draft
    [HeaterDisplay.kicad_pcb, HeaterMCU.kicad_pcb, HeaterMCU.kicad_sch, HeaterPSU.kicad_pcb, HeaterPSU.kicad_sch]
2022-10-30 Minor layout changes
    [HeaterMCU-B_Cu.gbl, HeaterMCU-B_Mask.gbs, HeaterMCU-B_Silkscreen.gbo, HeaterMCU-Edge_Cuts.gm1, HeaterMCU-F_Cu.gtl, HeaterMCU-F_Mask.gts, HeaterMCU-F_Silkscreen.gto, HeaterMCU-NPTH.drl]
2022-10-30 Added Power Input board
    [PowerInput-B_Cu.gbl, PowerInput-B_Mask.gbs, PowerInput-B_Silkscreen.gbo, PowerInput-Edge_Cuts.gm1, PowerInput-F_Cu.gtl, PowerInput-F_Mask.gts, PowerInput-F_Silkscreen.gto, PowerInput-NPTH.drl]
2022-10-31 Added filtering on PSU1 secondary
    [PowerInput-B_Cu.gbl, PowerInput-B_Mask.gbs, PowerInput-B_Silkscreen.gbo, PowerInput-Edge_Cuts.gm1, PowerInput-F_Cu.gtl, PowerInput-F_Mask.gts, PowerInput-F_Silkscreen.gto, PowerInput-NPTH.drl]
2022-11-03 Added holders for EMI shield
    [ShieldHolder.stl]
2022-11-14 Larger mounting hole for rotary switch
    [HeaterMCU-B_Cu.gbl, HeaterMCU-B_Mask.gbs, HeaterMCU-B_Silkscreen.gbo, HeaterMCU-Edge_Cuts.gm1, HeaterMCU-F_Cu.gtl, HeaterMCU-F_Mask.gts, HeaterMCU-F_Silkscreen.gto, HeaterMCU-NPTH.drl]
2022-11-14 Added load resistor, updated annotation, changed NTC footprint
    [HeaterPSU-B_Cu.gbl, HeaterPSU-B_Mask.gbs, HeaterPSU-B_Silkscreen.gbo, HeaterPSU-Edge_Cuts.gm1, HeaterPSU-F_Cu.gtl, HeaterPSU-F_Mask.gts, HeaterPSU-F_Silkscreen.gto, HeaterPSU-NPTH.drl]
2022-11-14 Changed inductor footprint
    [HeaterPSU-B_Cu.gbl, HeaterPSU-B_Mask.gbs, HeaterPSU-B_Silkscreen.gbo, HeaterPSU-Edge_Cuts.gm1, HeaterPSU-F_Cu.gtl, HeaterPSU-F_Mask.gts, HeaterPSU-F_Silkscreen.gto, HeaterPSU-NPTH.drl]
2022-11-14 Updated annotation
    [HeaterMCU-B_Cu.gbl, HeaterMCU-B_Mask.gbs, HeaterMCU-B_Silkscreen.gbo, HeaterMCU-Edge_Cuts.gm1, HeaterMCU-F_Cu.gtl, HeaterMCU-F_Mask.gts, HeaterMCU-F_Silkscreen.gto, HeaterMCU-NPTH.drl]
2022-11-18 Added filtering caps for heater elevation
2022-12-02 Changed resistor values
    [HeaterPSU.kicad_sch]
2022-12-03 MCU Board adapted for 3.3V operation
    [HeaterMCU.kicad_pcb, HeaterMCU.kicad_sch, HeaterPSU.kicad_pcb, HeaterPSU.kicad_sch]
2022-12-04 Optocouplers moved to from PSU to MCU board
    [HeaterMCU-B_Cu.gbl, HeaterMCU-B_Mask.gbs, HeaterMCU-B_Silkscreen.gbo, HeaterMCU-Edge_Cuts.gm1, HeaterMCU-F_Cu.gtl, HeaterMCU-F_Mask.gts, HeaterMCU-F_Silkscreen.gto, HeaterMCU-NPTH.drl]
2022-12-04 Swapped IO pins
    [HeaterMCU-B_Cu.gbl, HeaterMCU-B_Mask.gbs, HeaterMCU-B_Silkscreen.gbo, HeaterMCU-Edge_Cuts.gm1, HeaterMCU-F_Cu.gtl, HeaterMCU-F_Mask.gts, HeaterMCU-F_Silkscreen.gto, HeaterMCU-NPTH.drl]
2022-12-04 Added PWM controlled MOSFET output for soft start
    [HeaterMCU-B_Cu.gbl, HeaterMCU-B_Mask.gbs, HeaterMCU-B_Silkscreen.gbo, HeaterMCU-Edge_Cuts.gm1, HeaterMCU-F_Cu.gtl, HeaterMCU-F_Mask.gts, HeaterMCU-F_Silkscreen.gto, HeaterMCU-NPTH.drl]
2022-12-05 Added 12V regulator for PWM output driver
    [HeaterMCU.kicad_pcb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]
2022-12-20 Updated component values
    [HeaterMCU.kicad_sch, HeaterPSU.kicad_sch]
2022-12-20 Added test code for display and power monitor
2022-12-26 New PSU based on XL4005
    Added current limiter
    Added interface to uTracer PIC
    [HeaterMCU-B_Cu.gbl, HeaterMCU-B_Mask.gbs, HeaterMCU-B_Silkscreen.gbo, HeaterMCU-Edge_Cuts.gm1, HeaterMCU-F_Cu.gtl, HeaterMCU-F_Mask.gts, HeaterMCU-F_Silkscreen.gto, HeaterMCU-NPTH.drl]
2022-12-28 Changed DC in label: 9V
2023-01-05 PIC interface board, version A
    [HeaterMCU.kicad_pcb, HeaterMCU.kicad_sch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]
2023-01-11 Rearranged schematic
    [HeaterMCU.kicad_sch]
2023-01-11 Updated pin names
    [HeaterMCU.kicad_sch, HeaterPSU.kicad_sch]
2023-01-11 Changed pin for MCU status LED
    [HeaterMCU-B_Cu.gbl, HeaterMCU-B_Mask.gbs, HeaterMCU-B_Silkscreen.gbo, HeaterMCU-Edge_Cuts.gm1, HeaterMCU-F_Cu.gtl, HeaterMCU-F_Mask.gts, HeaterMCU-F_Silkscreen.gto, HeaterMCU-NPTH.drl]
2023-01-12 Adjusted position for potmeter hole
    [HeaterMCU-B_Cu.gbl, HeaterMCU-B_Mask.gbs, HeaterMCU-B_Silkscreen.gbo, HeaterMCU-Edge_Cuts.gm1, HeaterMCU-F_Cu.gtl, HeaterMCU-F_Mask.gts, HeaterMCU-F_Silkscreen.gto, HeaterMCU-NPTH.drl]
2023-01-22 Added output filter caps + spacing around mounting holes
    [CableProtection_1A.stl, CableProtection_1B.stl, CableProtection_2A.stl, CableProtection_2B.stl, HeaterHolder.stl, HeaterMCU.kicad_pcb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]
2023-01-23 New status LED layout
    [HeaterMCU-B_Cu.gbl, HeaterMCU-B_Mask.gbs, HeaterMCU-B_Silkscreen.gbo, HeaterMCU-Edge_Cuts.gm1, HeaterMCU-F_Cu.gtl, HeaterMCU-F_Mask.gts, HeaterMCU-F_Silkscreen.gto, HeaterMCU-NPTH.drl]
2023-01-23 Changed LED footprints to 0603
    [HeaterPSU-B_Cu.gbl, HeaterPSU-B_Mask.gbs, HeaterPSU-B_Silkscreen.gbo, HeaterPSU-Edge_Cuts.gm1, HeaterPSU-F_Cu.gtl, HeaterPSU-F_Mask.gts, HeaterPSU-F_Silkscreen.gto, HeaterPSU-NPTH.drl]
2023-01-23 Added indent in PCB for FFC cable
    [HeaterMCU-B_Cu.gbl, HeaterMCU-B_Mask.gbs, HeaterMCU-B_Silkscreen.gbo, HeaterMCU-Edge_Cuts.gm1, HeaterMCU-F_Cu.gtl, HeaterMCU-F_Mask.gts, HeaterMCU-F_Silkscreen.gto, HeaterMCU-NPTH.drl]
2023-02-12 Added project pictures
    [HeaterMCU.kicad_sch, HeaterPSU.kicad_sch]
2023-02-12 Changed component values
    [HeaterPSU.kicad_sch]
2023-02-17 Adjusted display text positions
    [ConnectorPlate.stl, HeaterFrontPanel.3mf, HeaterFrontPanel.stl, HeaterFrontPanel_Fastener.stl, HoleCover.stl]
2023-02-17 4 screw attachment for front panel
    [HeaterFrontPanel.3mf, HeaterFrontPanel.stl, HeaterFrontPanel_Fastener.stl]
2023-02-20 Fixed display update bug
    [TubePlate_Frame.stl, TubePlate_Frame2.stl]
2023-02-24 Added Front panel labels
    [HeaterMCU.kicad_sch]
2023-03-11 Digital heater PSU, first draft
    [HeaterPSU_Digital-B_Cu.gbl, HeaterPSU_Digital-B_Mask.gbs, HeaterPSU_Digital-B_Paste.gbp, HeaterPSU_Digital-B_Silkscreen.gbo, HeaterPSU_Digital-Edge_Cuts.gm1, HeaterPSU_Digital-F_Cu.gtl, HeaterPSU_Digital-F_Mask.gts, HeaterPSU_Digital-F_Paste.gtp]
2023-03-12 Added driver stage for output MOSFET
    [HeaterPSU_Digital.kicad_pcb, HeaterPSU_Digital.kicad_sch]
2023-05-01 File cleanup
    [HeaterPSU_Digital-B_Cu.gbl, HeaterPSU_Digital-B_Mask.gbs, HeaterPSU_Digital-B_Paste.gbp, HeaterPSU_Digital-B_Silkscreen.gbo, HeaterPSU_Digital-Edge_Cuts.gm1, HeaterPSU_Digital-F_Cu.gtl, HeaterPSU_Digital-F_Mask.gts, HeaterPSU_Digital-F_Paste.gtp]
2023-05-12 Added BOM (bill of materials)
    [BOM_HeaterMCU.csv, BOM_HeaterPSU.csv, BOM_PIC_Interface.csv, BOM_PowerInput.csv, HeaterMCU.kicad_pcb, HeaterMCU.kicad_sch, HeaterPSU.kicad_sch, PIC_Interface.kicad_sch]
